rohith8988/Custom_monitor/v2/aluminium_spine/spine_3mm_drawing_1to1_A4.pdf

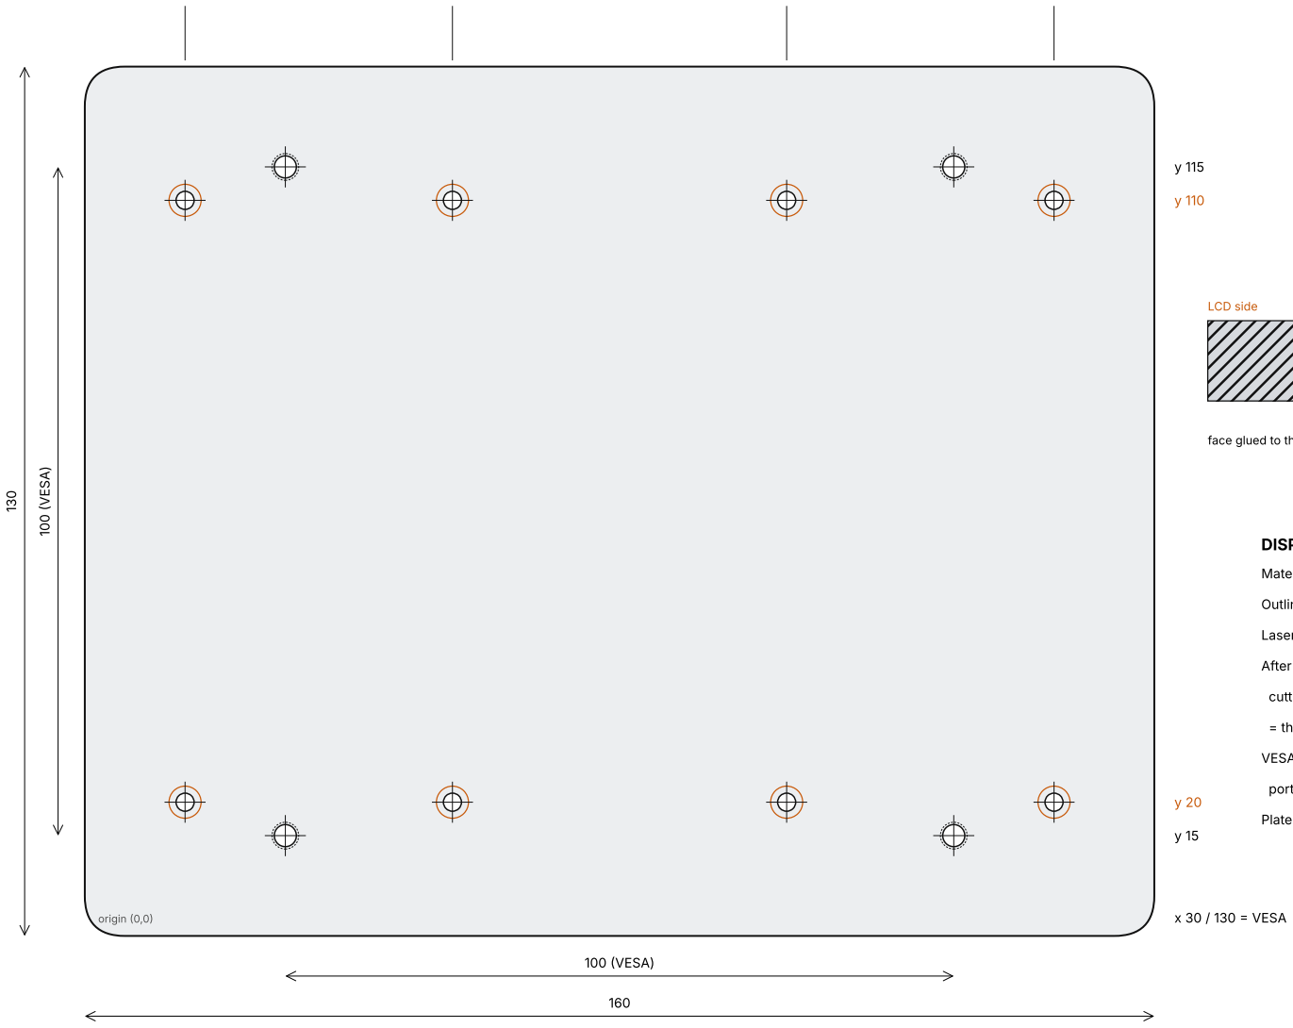
[picture p11: figure]
100 (VESA); origin (0,0); x 30 / 130 = VESA; LCD side

M2.5 holes at x = 15, 55, 105, 145

50 mm: measure this after printing (print at 100 %, no 'fit to page')

M4 x 0.7
tap through
(Ø3.3 cut)

Ø2.7 through,
90° csk Ø4.8
on the LCD side

face glued to the rear panel (z = 0)

## Section detail, 4:1 (not to scale with the plate)

### DISPLAY CASE v2 - ALUMINIUM SPINE (VESA carrier)

Material: aluminium 6061-T6 (5052 OK), 3.0 mm. Qty 1. Deburr all edges.

Outline 160 x 130, R6 corners. Drawing is 1:1 on A4 (also a drilling template).

Laser cut: outline + 4 x Ø3.3 (+ 8 x Ø2.7 if accepted).

After cutting: tap the 4 x Ø3.3 holes M4 x 0.7 THROUGH (plain M4 tap,

cutting fluid). Countersink the 8 x Ø2.7 holes 90° to Ø4.8 on ONE face

= the LCD side. The other face is epoxied to the rear panel.

VESA screw: M4 must stick out <= 5.5 mm past the arm plate (M4 x 8 with the

portable stand's plate gives 4.4). Longer reaches toward the LCD.

Plate is symmetric: any orientation, only the countersink face matters.
