rohith8988/Custom_monitor/images/controller_board.png

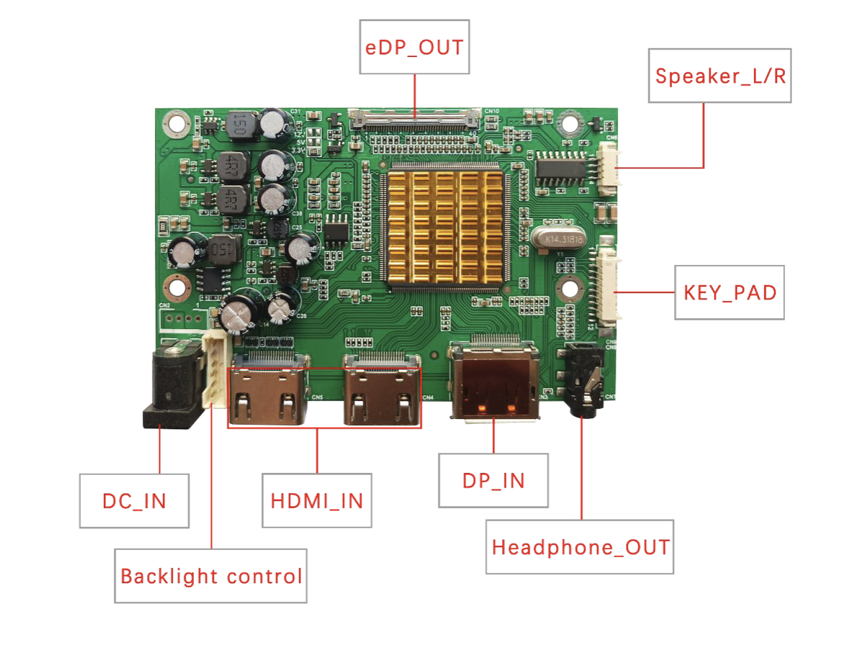
images/controller_board.png
