rohith8988/Custom_monitor/images/controller_board_diagram.png

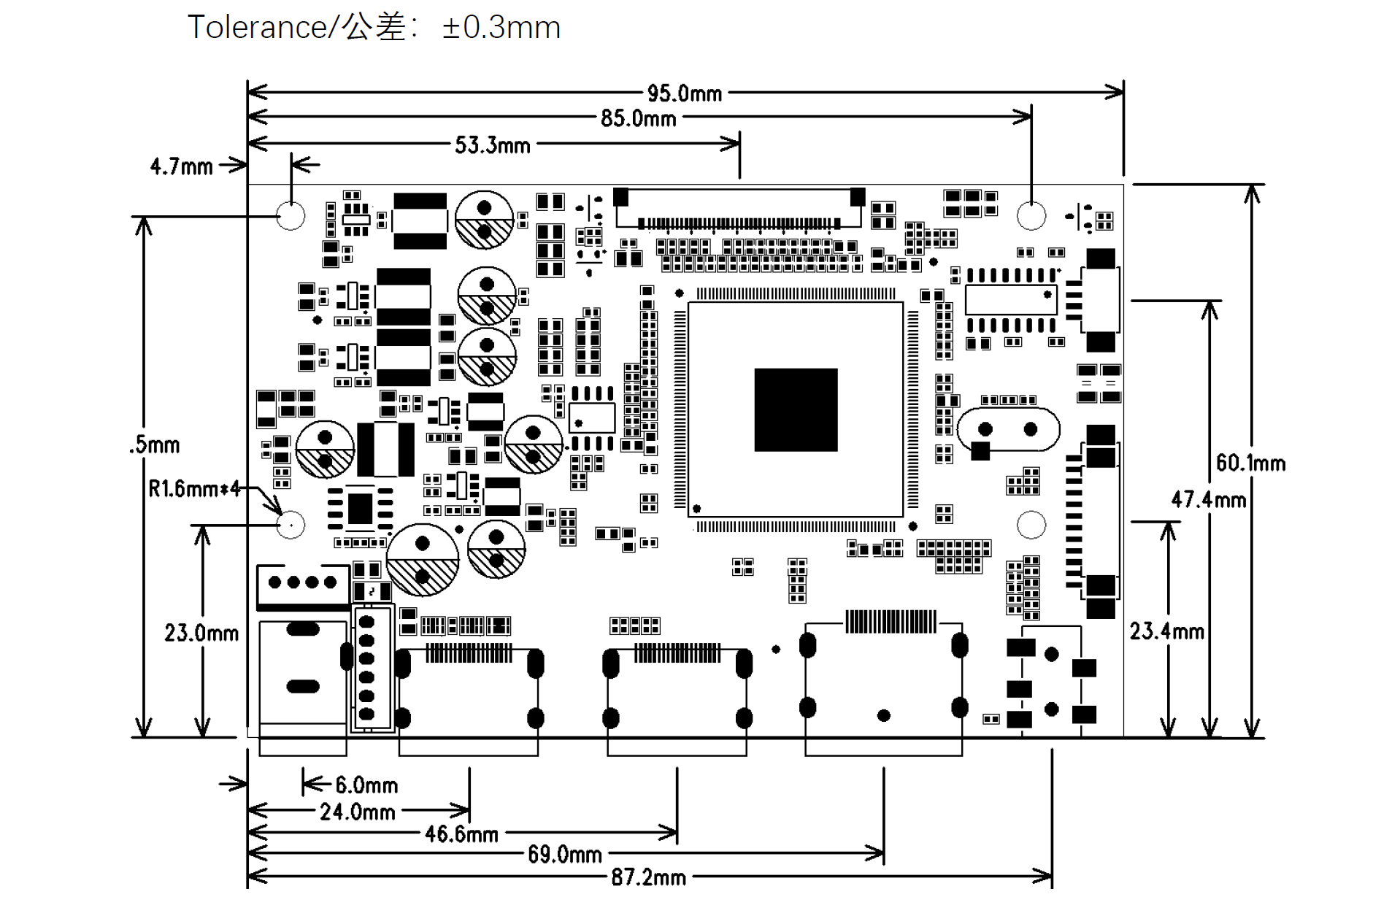
images/controller_board_diagram.png
