rohith8988/Custom_monitor/images/inspiration_pic_1.png

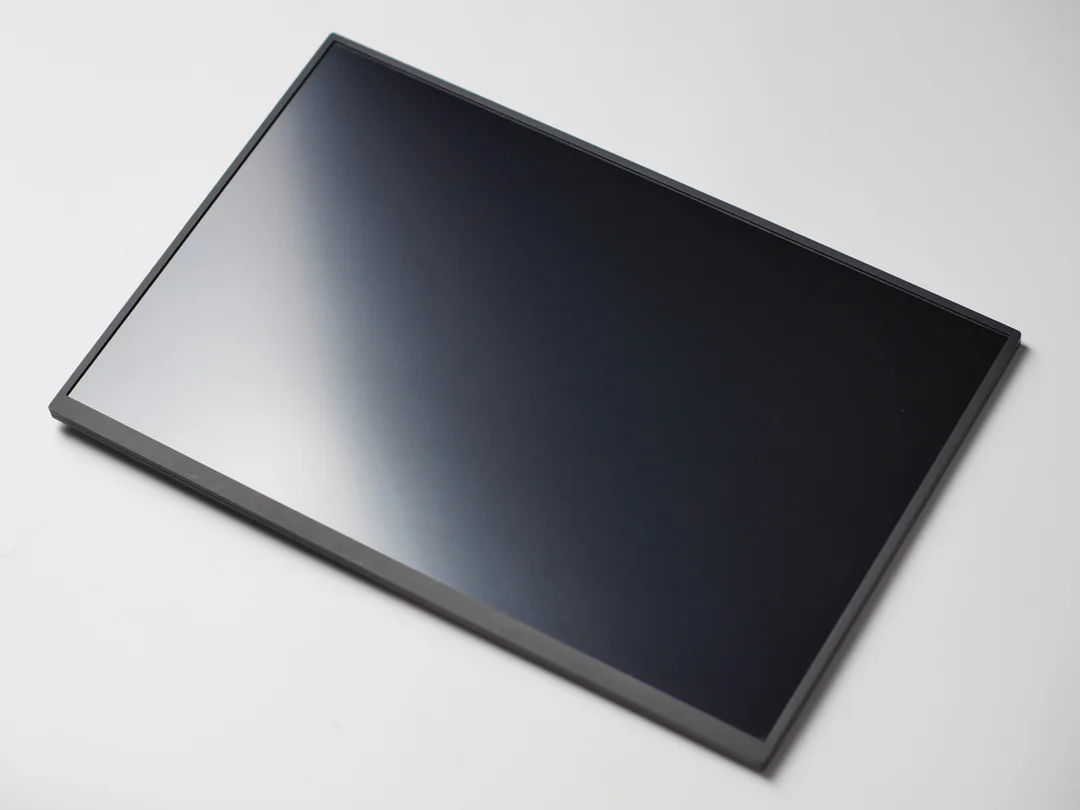
images/inspiration_pic_1.png
