rohith8988/Custom_monitor/images/inspiration_pic_2.png

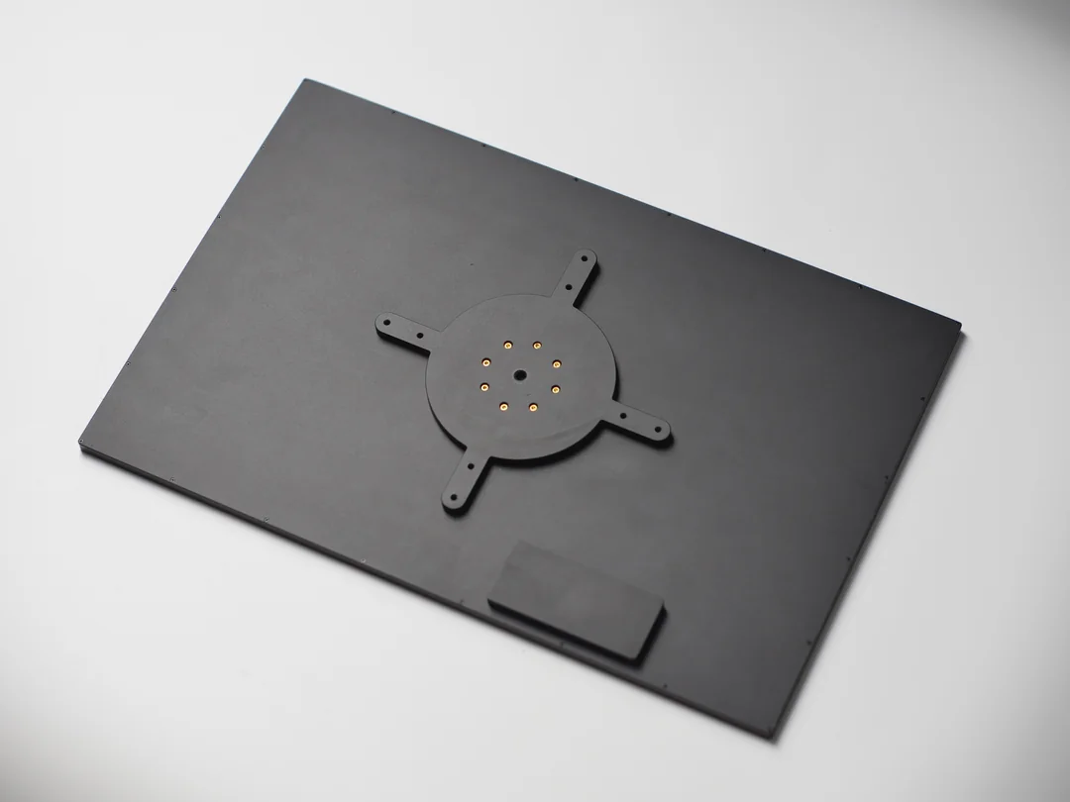
images/inspiration_pic_2.png
