rohith8988/Custom_monitor/images/inspiration_pic_3.png

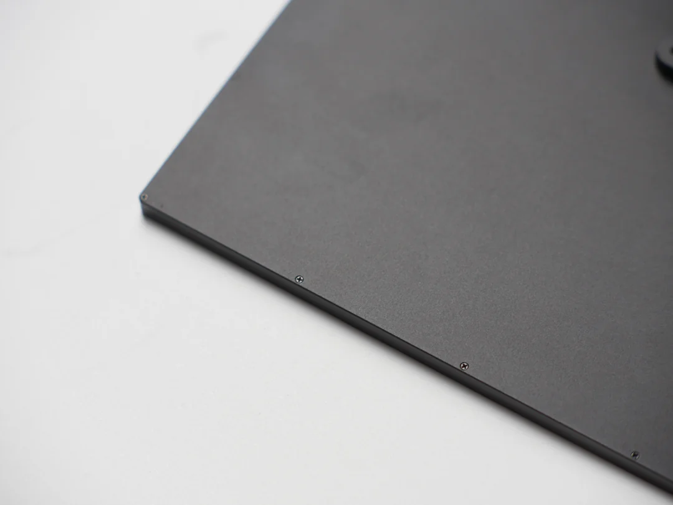
images/inspiration_pic_3.png
