rohith8988/Custom_monitor/images/inspiration_pic_4.png

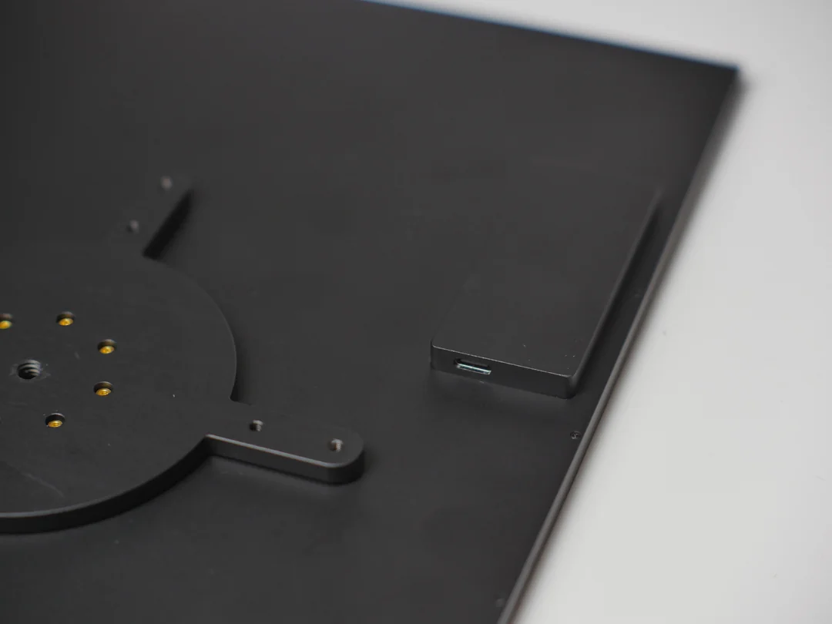
images/inspiration_pic_4.png
