rohith8988/Custom_monitor/stand/renders/front_three_quarter.png

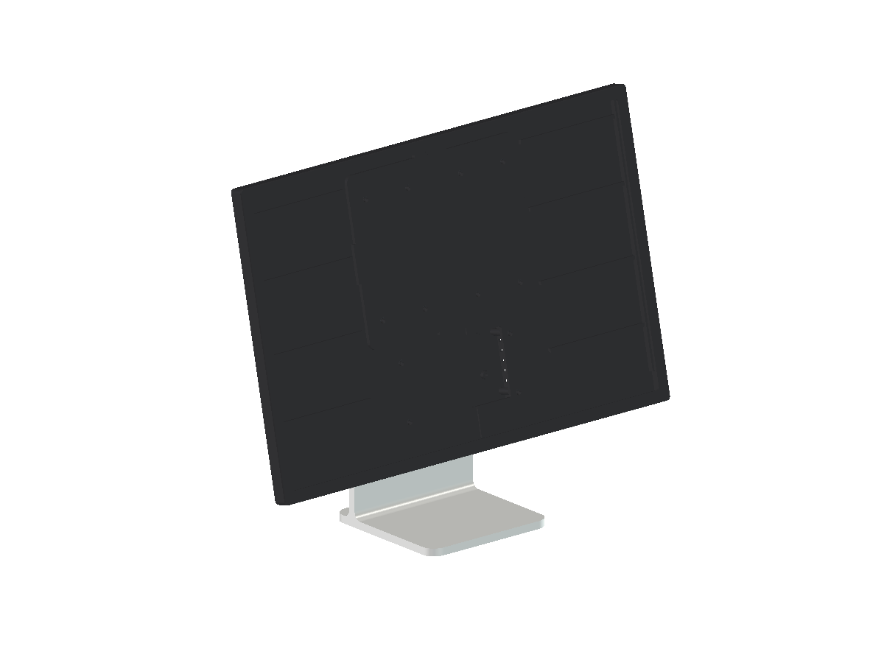
stand/renders/front_three_quarter.png
