rohith8988/Custom_monitor/stand_portable/renders/folded.png

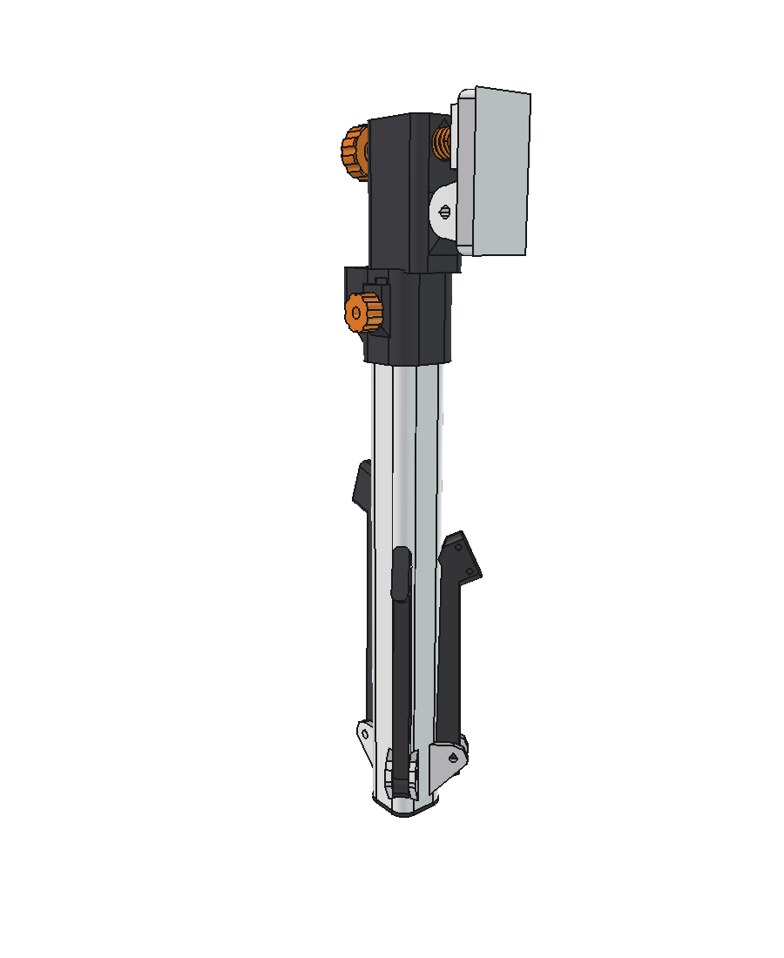
stand_portable/renders/folded.png
