rohith8988/Custom_monitor/stand_portable/renders/stacked_rear_three_quarter.png

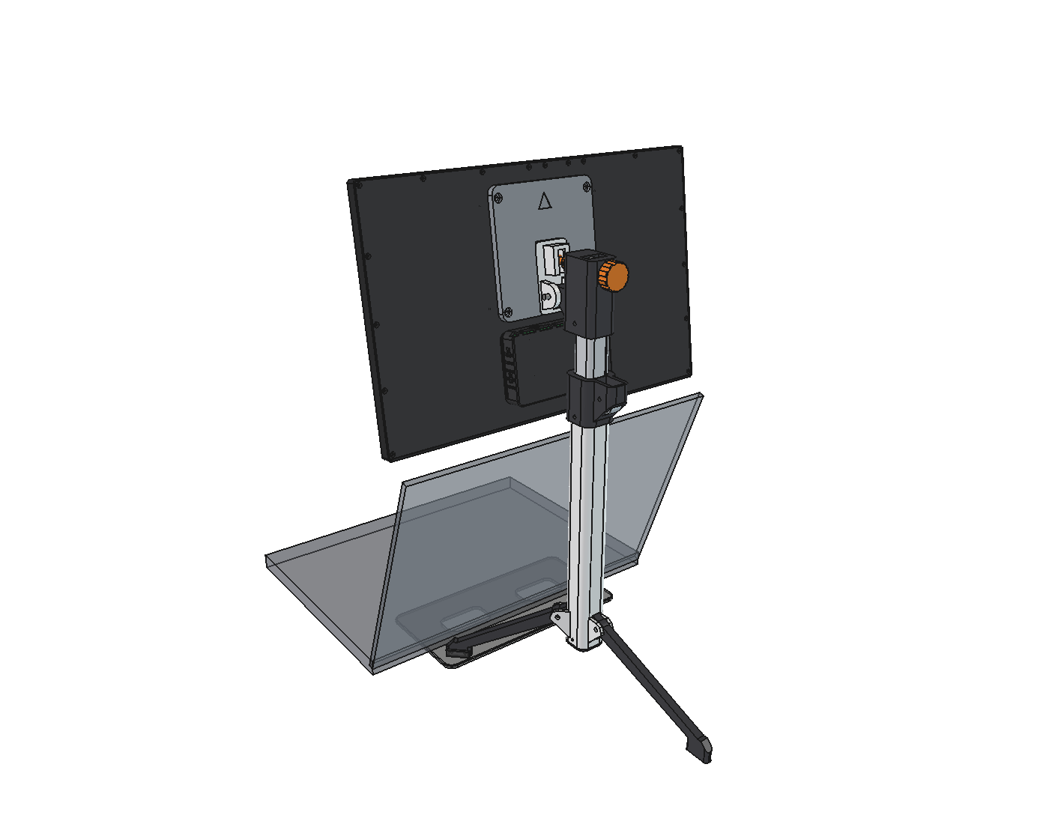
stand_portable/renders/stacked_rear_three_quarter.png
