rohith8988/Custom_monitor/stand_portable/renders/stand_only.png

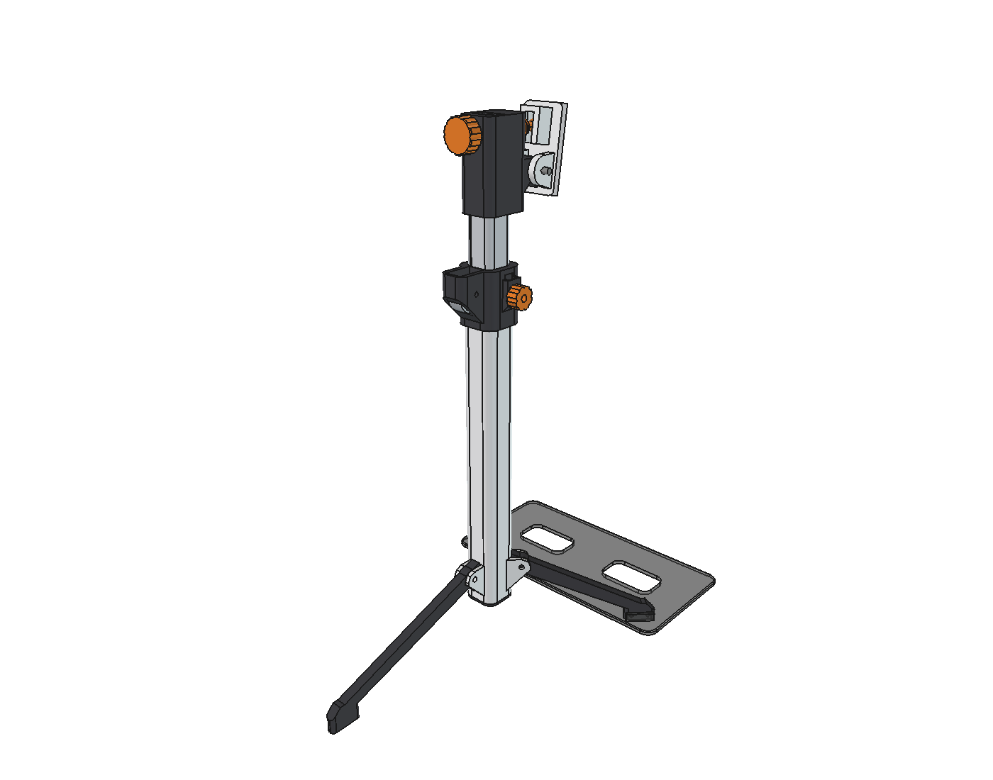
stand_portable/renders/stand_only.png
