rohith8988/Custom_monitor/v3/renders/rear_panel_inside.png

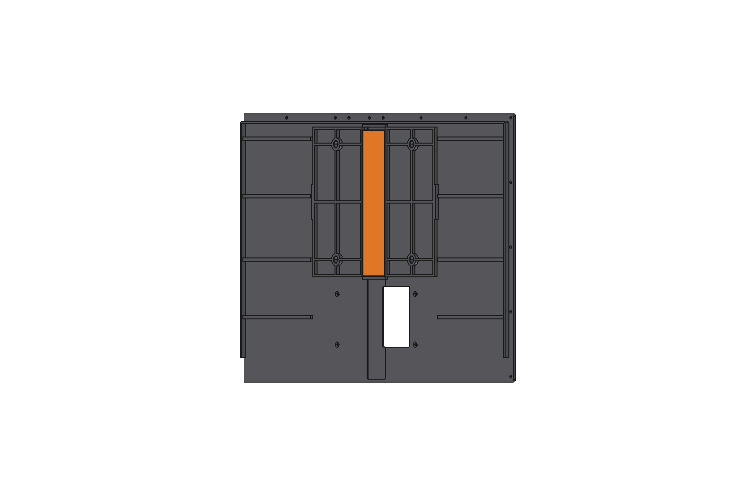
v3/renders/rear_panel_inside.png
