rohith8988/Custom_monitor/stand/source/_case_refs/io_block.stl

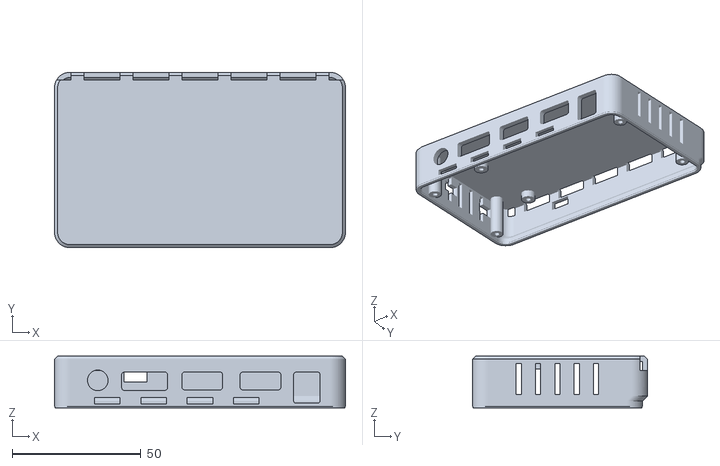
[picture p23: CAD file, 2026-11-06]
stand/source/_case_refs/io_block.stl
113.0 x 68.1 x 20.1
