rohith8988/Custom_monitor/stand_portable/3d_print_files/brake_pad.step

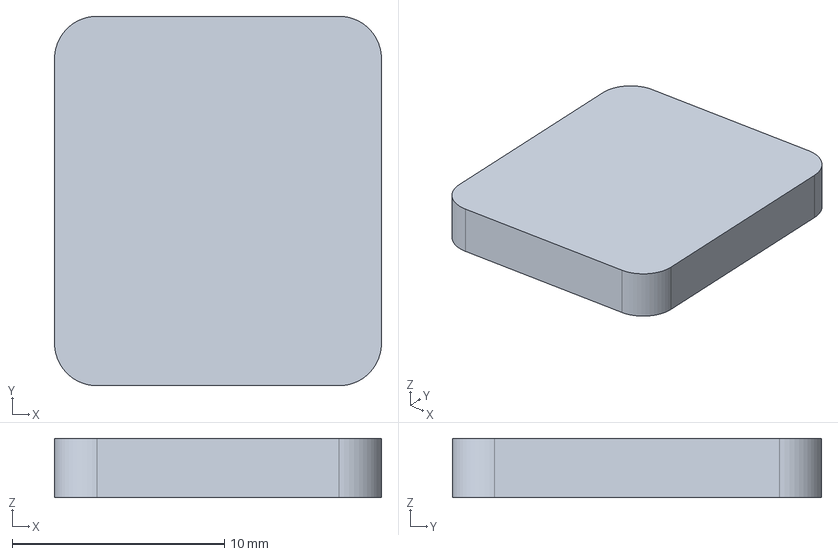
[picture p24: CAD file, 2026-11-06]
stand_portable/3d_print_files/brake_pad.step
15.4 x 17.4 x 2.80 mm
