rohith8988/Custom_monitor/stand_portable/stand_portable_folded.FCStd

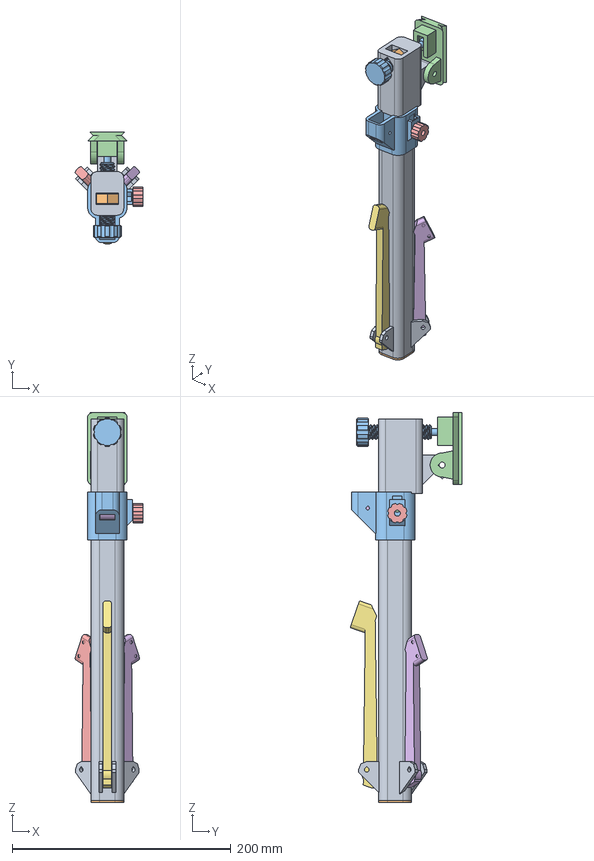
[picture p25: CAD file, 2026-11-06]
stand_portable/stand_portable_folded.FCStd
62.0 x 102.1 x 356.5 mm
outer_tube
bottom_cap
top_collar
brake_pad
brake_knob
spring_drum
inner_tube
inner_foot
head
tilt_nut
tilt_screw
bracket
leg_front_L
leg_front_R
leg_rear
