rohith8988/Custom_monitor/v3/3d_print_files/front_frame_R.step

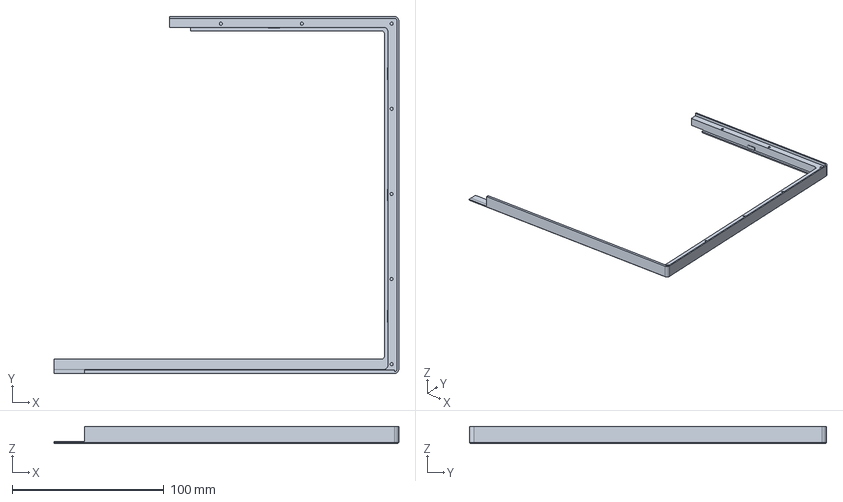
[picture p26: CAD file, 2026-11-06]
v3/3d_print_files/front_frame_R.step
227.4 x 235.5 x 11.3 mm
