rohith8988/Custom_monitor/v3/monitor_case_v3.FCStd

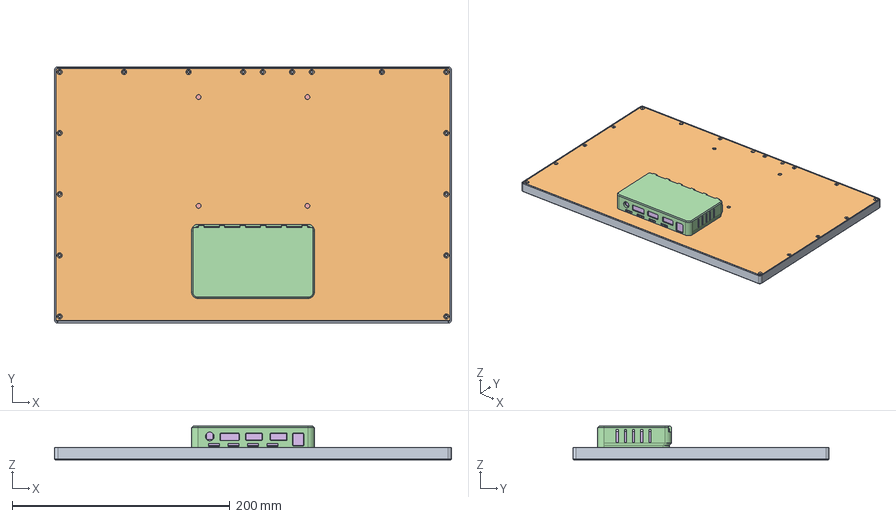
[picture p27: CAD file, 2026-11-06]
v3/monitor_case_v3.FCStd
364.8 x 235.5 x 30.8 mm
front_frame
rear_panel
seam_bridge
io_block
panel_ref
board_ref
