rohith8988/Custom_monitor/v3/print_beds/bed3_rear_panel_L/bed3_rear_panel_L.step

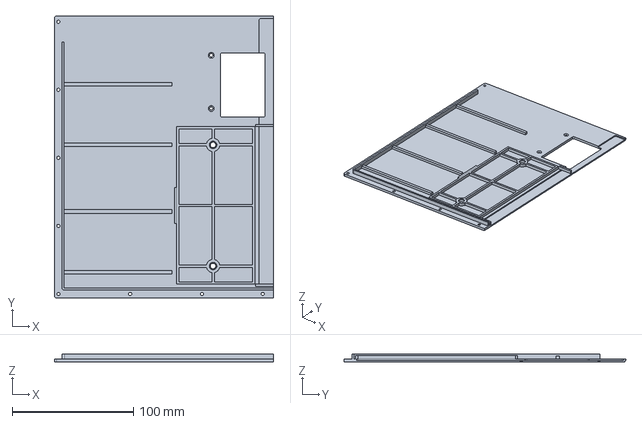
[picture p28: CAD file, 2026-11-06]
v3/print_beds/bed3_rear_panel_L/bed3_rear_panel_L.step
181.0 x 232.7 x 6.70 mm
