rohith8988/Custom_monitor/v3/print_beds/bed4_rear_panel_R/bed4_rear_panel_R.step

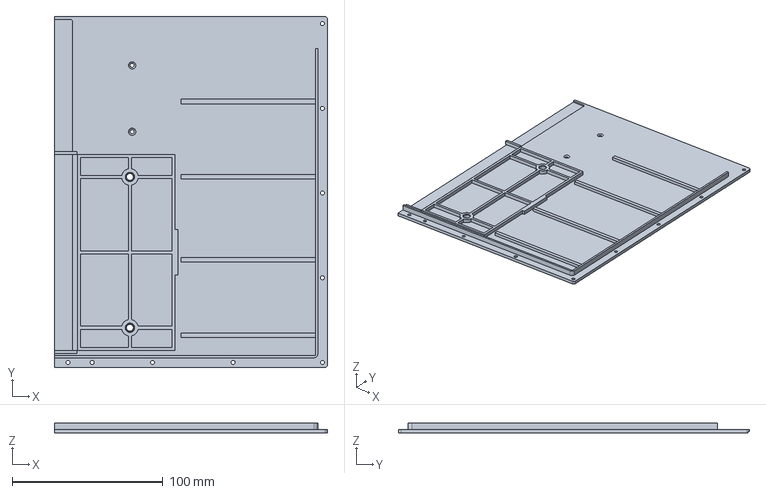
[picture p29: CAD file, 2026-11-06]
v3/print_beds/bed4_rear_panel_R/bed4_rear_panel_R.step
181.0 x 232.7 x 6.70 mm
