rohith8988/Custom_monitor/v3/print_beds/bed5_io_block_splice/bed5_io_block_splice.step

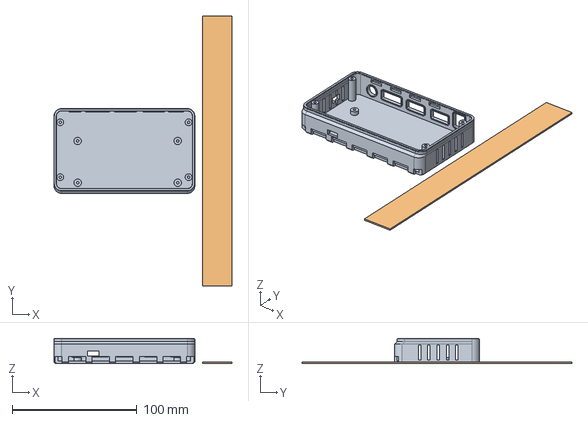
[picture p30: CAD file, 2026-11-06]
v3/print_beds/bed5_io_block_splice/bed5_io_block_splice.step
142.9 x 216.4 x 20.1 mm
