rohith8988/Custom_monitor/v3/print_beds/bed5_io_block_splice/originals/rear_splice.step

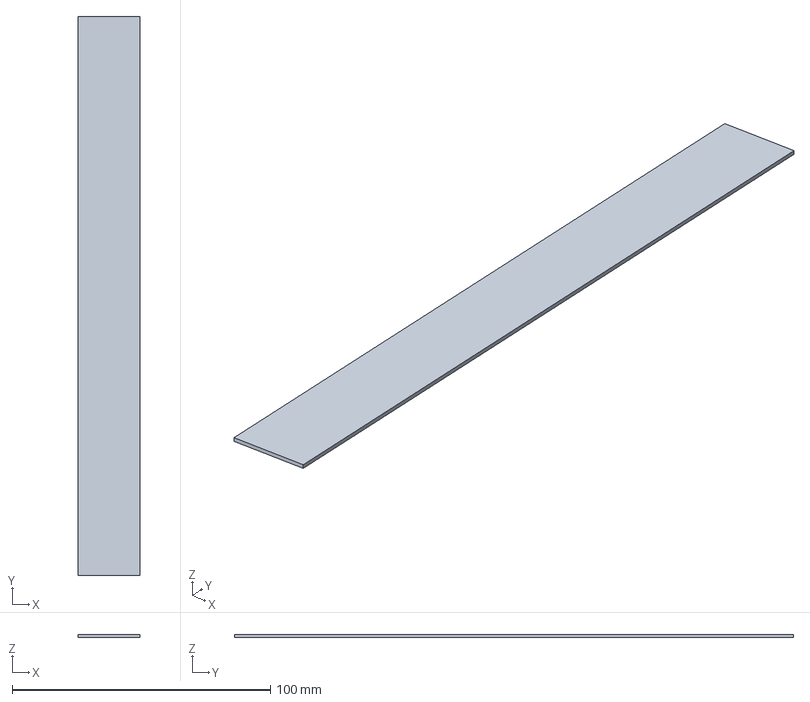
[picture p31: CAD file, 2026-11-06]
v3/print_beds/bed5_io_block_splice/originals/rear_splice.step
23.9 x 216.4 x 1.15 mm
