rohith8988/Custom_monitor/v3/print_beds/bed6_seam_bridge/bed6_seam_bridge.step

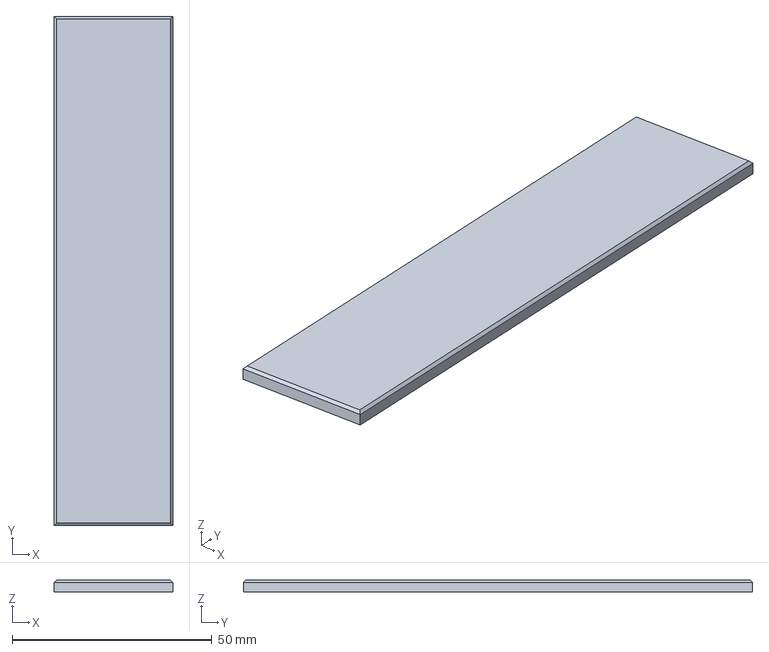
[picture p32: CAD file, 2026-11-06]
v3/print_beds/bed6_seam_bridge/bed6_seam_bridge.step
29.7 x 127.4 x 3.00 mm
