rohith8988/Custom_monitor/stand/source/_case_refs/spine.stl

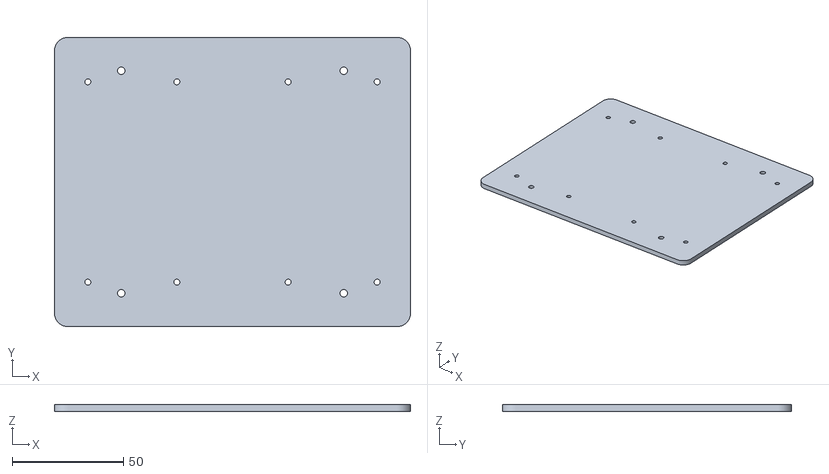
[picture p33: CAD file, 2026-11-06]
stand/source/_case_refs/spine.stl
160.0 x 130.0 x 3.00
