rohith8988/Custom_monitor/stand_portable/3d_print_files/vesa_plate.step

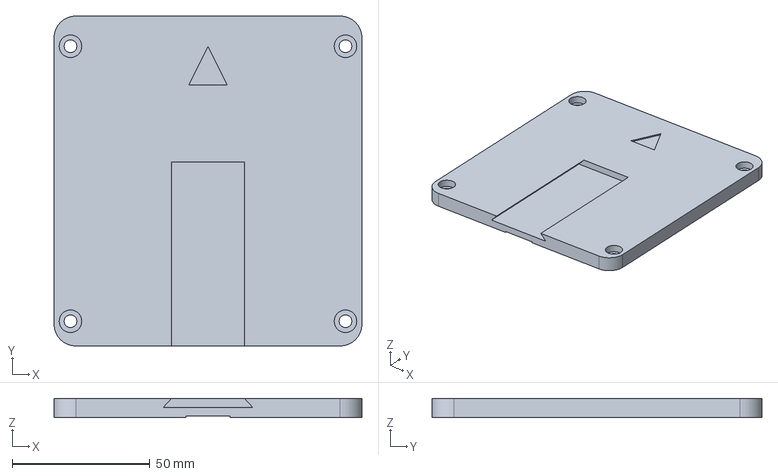
[picture p34: CAD file, 2026-11-06]
stand_portable/3d_print_files/vesa_plate.step
112.0 x 120.0 x 7.00 mm
