rohith8988/Custom_monitor/stand_portable/stand_portable.FCStd

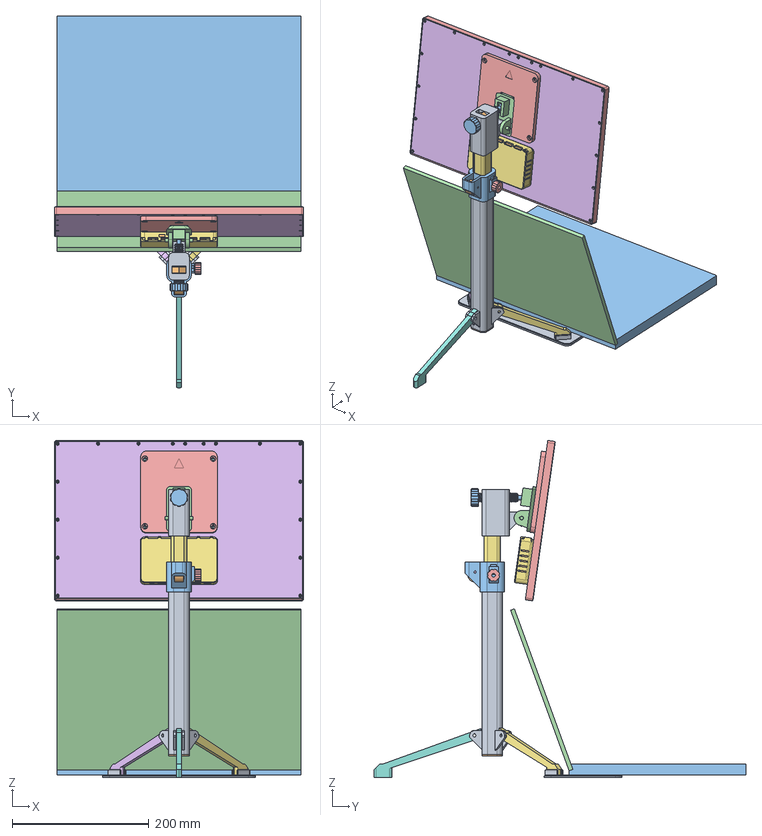
[picture p35: CAD file, 2026-11-06]
stand_portable/stand_portable.FCStd
364.8 x 544.3 x 493.2 mm
outer_tube
bottom_cap
top_collar
brake_pad
brake_knob
spring_drum
inner_tube
inner_foot
head
tilt_nut
tilt_screw
bracket
vesa_plate
leg_front_L
leg_front_R
leg_rear
laptop_plate
cf_spring_coil
cf_spring_strip
m5_pivot
front_frame
rear_panel
io_block
spine
panel_ref
board_ref
laptop_deck
laptop_lid
