rohith8988/Custom_monitor/stand/source/_case_refs/rear_panel.stl

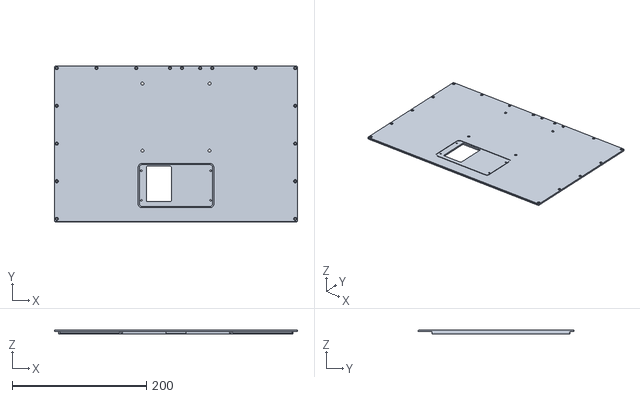
[picture p36: CAD file, 2026-11-06]
stand/source/_case_refs/rear_panel.stl
362.0 x 232.7 x 6.70
