rohith8988/Custom_monitor/stand_portable/3d_print_files/spring_drum.step

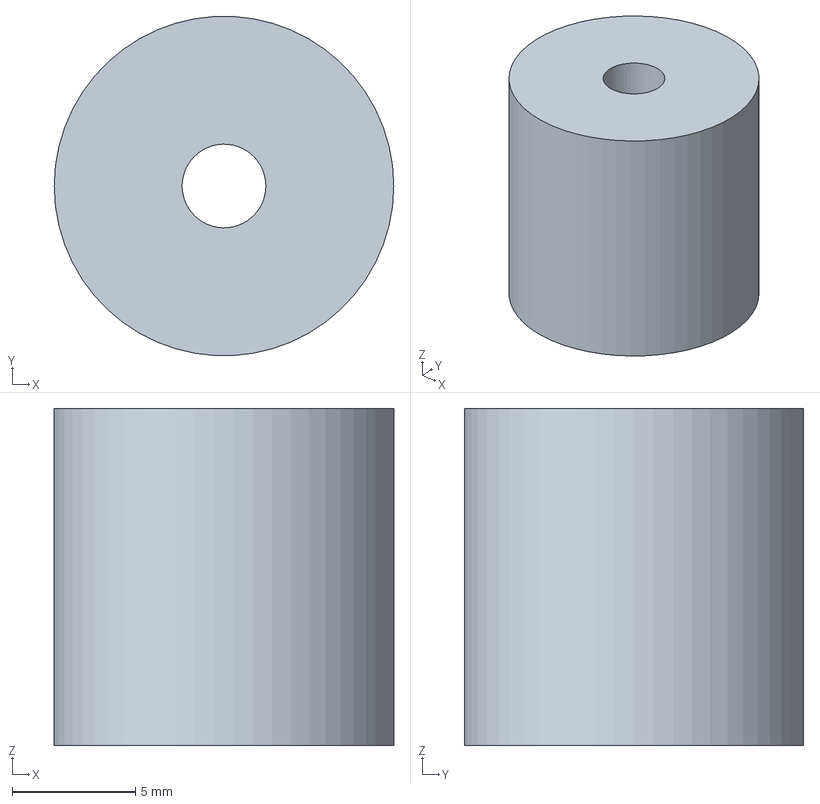
[picture p37: CAD file, 2026-11-06]
stand_portable/3d_print_files/spring_drum.step
13.8 x 13.8 x 13.7 mm
