rohith8988/Custom_monitor/stand/source/_case_refs/front_frame.stl

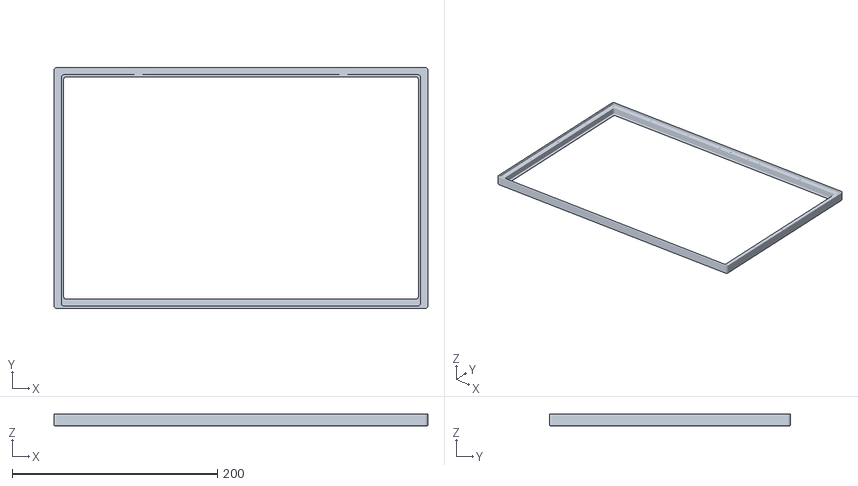
[picture p38: CAD file, 2026-11-06]
stand/source/_case_refs/front_frame.stl
364.8 x 235.5 x 11.3
