rohith8988/Custom_monitor/stand_portable/3d_print_files/inner_foot.step

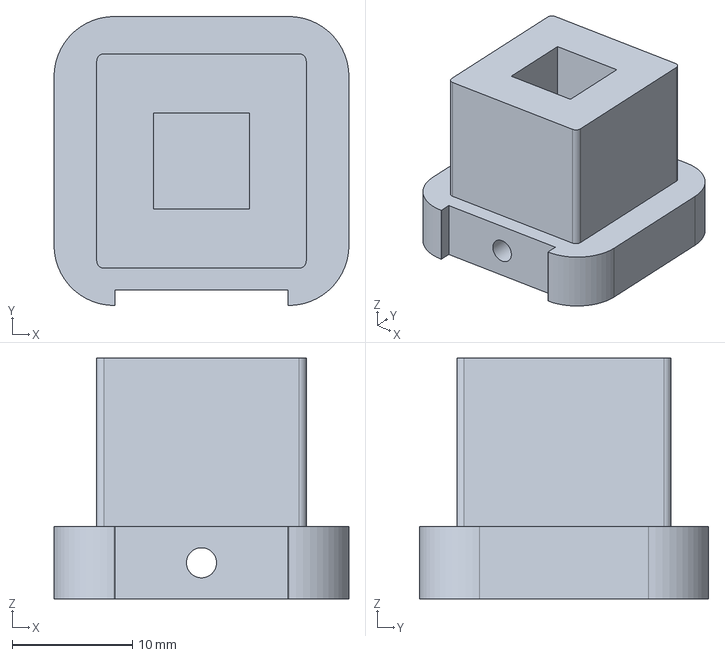
[picture p39: CAD file, 2026-11-06]
stand_portable/3d_print_files/inner_foot.step
24.5 x 24.0 x 20.0 mm
