rohith8988/Custom_monitor/stand_portable/3d_print_files/laptop_plate.step

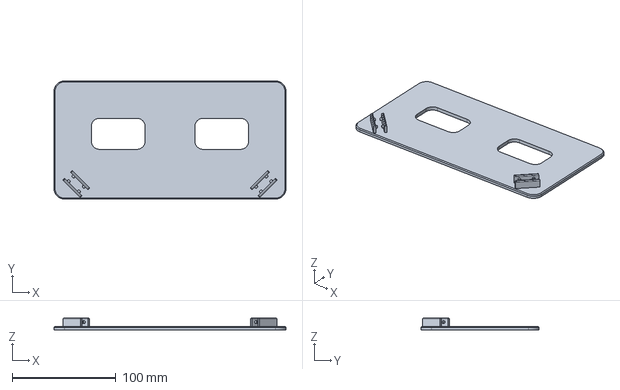
[picture p40: CAD file, 2026-11-06]
stand_portable/3d_print_files/laptop_plate.step
224.0 x 114.0 x 11.5 mm
