rohith8988/Custom_monitor/stand_portable/3d_print_files/bottom_cap.step

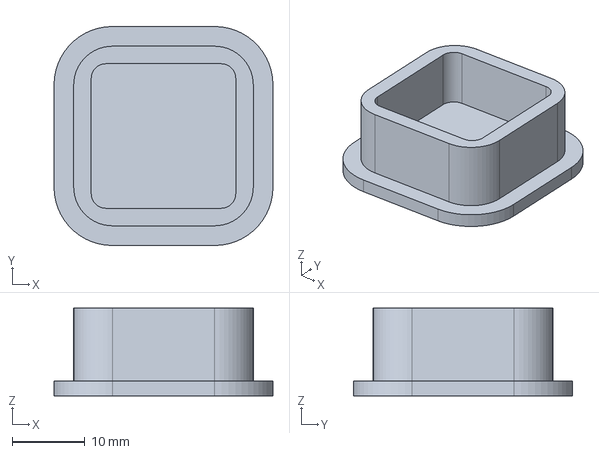
[picture p41: CAD file, 2026-11-06]
stand_portable/3d_print_files/bottom_cap.step
30.0 x 30.0 x 12.0 mm
