rohith8988/Custom_monitor/stand_portable/3d_print_files/brake_knob.step

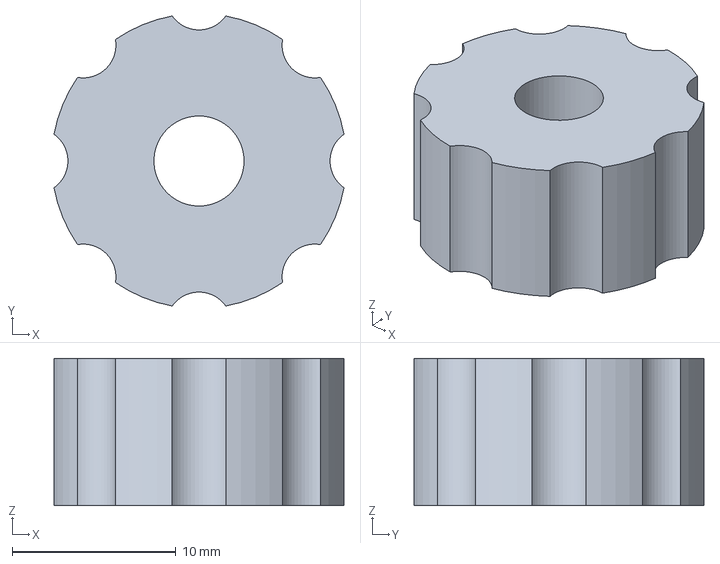
[picture p42: CAD file, 2026-11-06]
stand_portable/3d_print_files/brake_knob.step
17.7 x 17.7 x 9.00 mm
