rohith8988/Custom_monitor/v3/3d_print_files/rear_panel_L_selfsupport.step

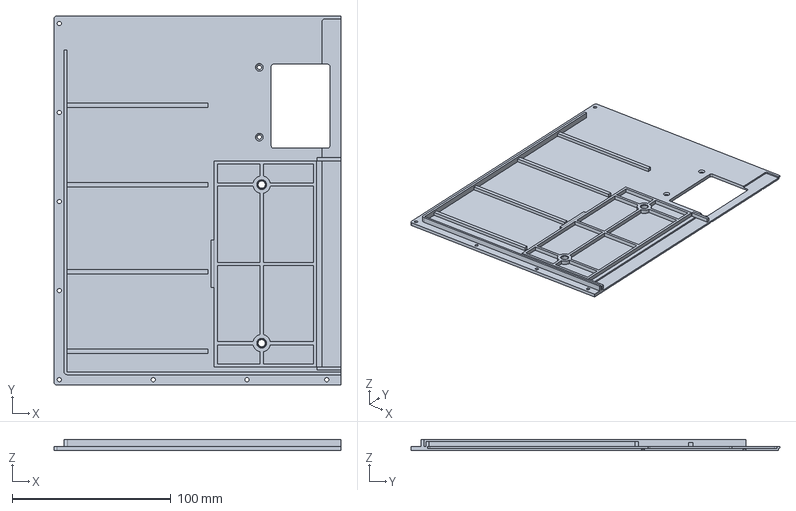
[picture p43: CAD file, 2026-11-06]
v3/3d_print_files/rear_panel_L_selfsupport.step
181.0 x 232.7 x 6.70 mm
