rohith8988/Custom_monitor/stand_portable/3d_print_files/top_collar.step

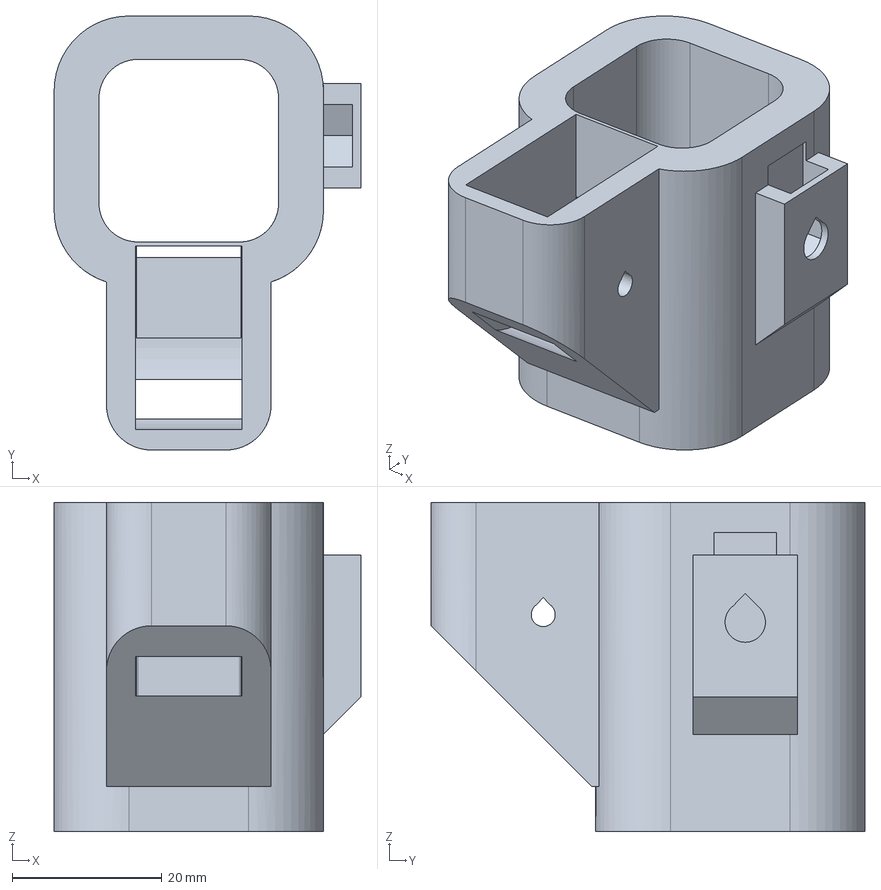
[picture p44: CAD file, 2026-11-06]
stand_portable/3d_print_files/top_collar.step
41.0 x 58.0 x 44.0 mm
