rohith8988/Custom_monitor/stand_portable/3d_print_files/inner_tube.step

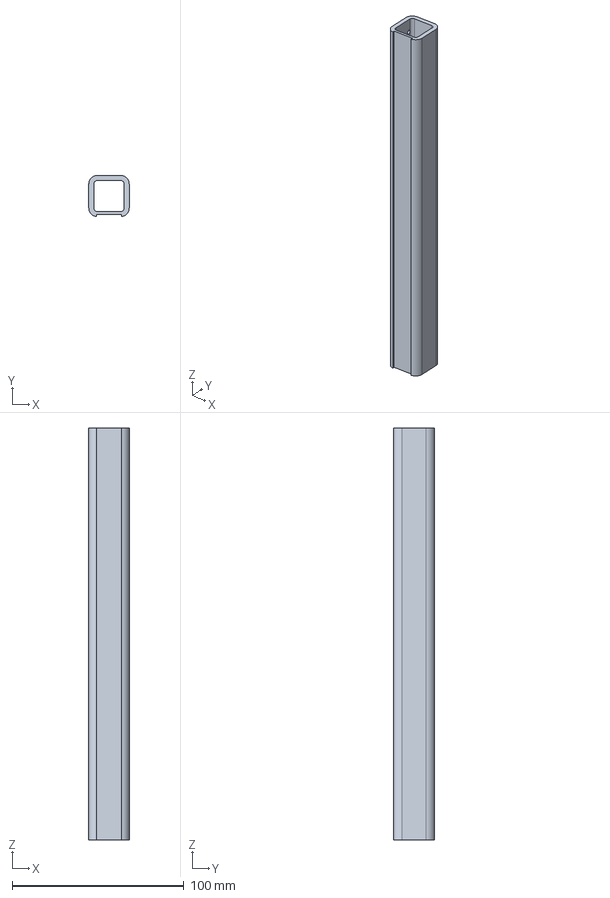
[picture p45: CAD file, 2026-11-06]
stand_portable/3d_print_files/inner_tube.step
23.6 x 24.0 x 240.0 mm
