rohith8988/Custom_monitor/stand_portable/3d_print_files/leg_front_R.step

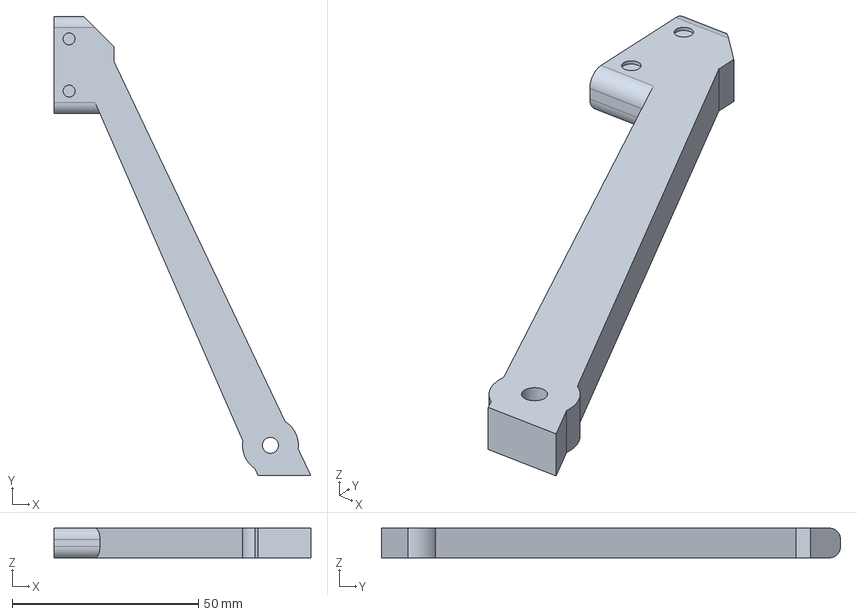
[picture p46: CAD file, 2026-11-06]
stand_portable/3d_print_files/leg_front_R.step
68.8 x 123.1 x 8.00 mm
