rohith8988/Custom_monitor/stand_portable/3d_print_files/leg_rear.step

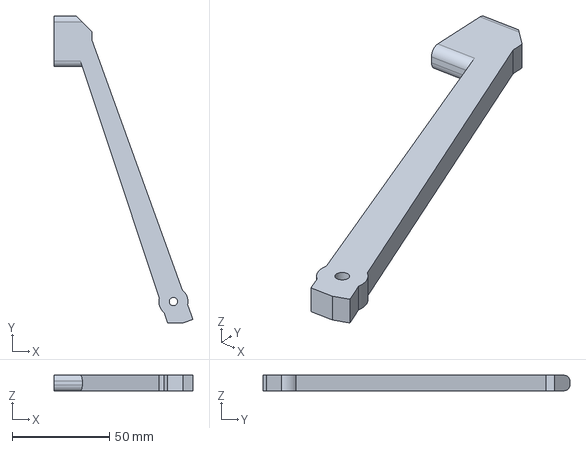
[picture p47: CAD file, 2026-11-06]
stand_portable/3d_print_files/leg_rear.step
71.6 x 158.0 x 8.00 mm
