rohith8988/Custom_monitor/stand_portable/3d_print_files/head.step

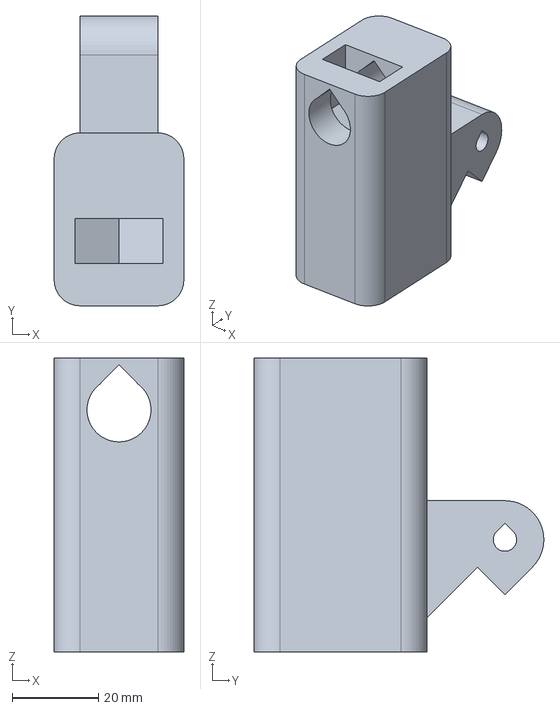
[picture p48: CAD file, 2026-11-06]
stand_portable/3d_print_files/head.step
30.0 x 67.0 x 68.0 mm
