rohith8988/Custom_monitor/stand_portable/3d_print_files/outer_tube.step

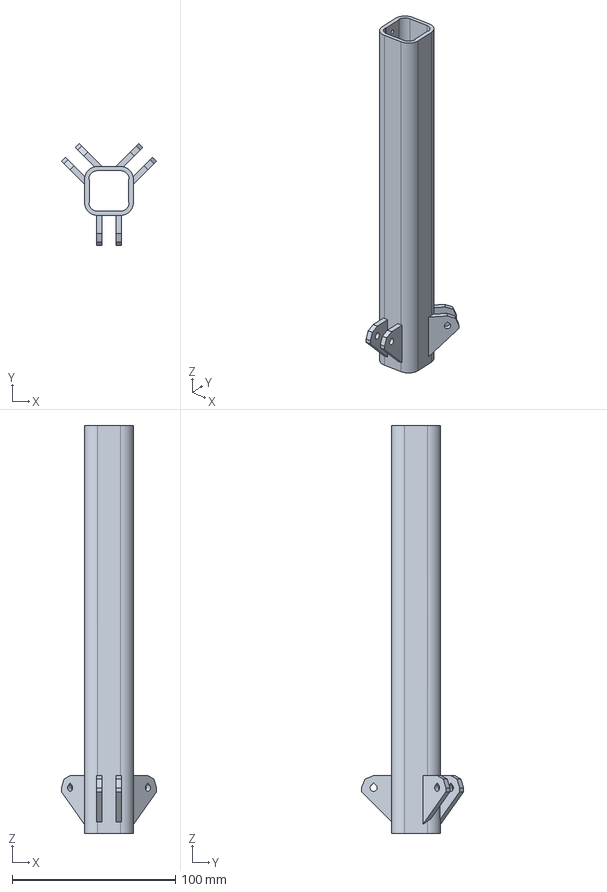
[picture p49: CAD file, 2026-11-06]
stand_portable/3d_print_files/outer_tube.step
58.3 x 62.6 x 250.0 mm
