rohith8988/Custom_monitor/stand_portable/3d_print_files/bracket.step

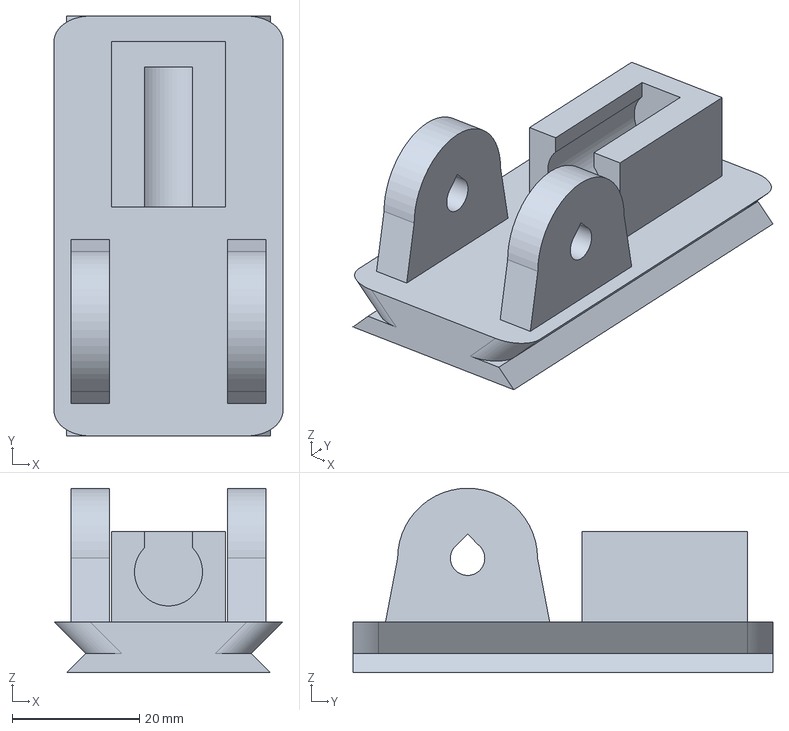
[picture p50: CAD file, 2026-11-06]
stand_portable/3d_print_files/bracket.step
36.0 x 66.0 x 29.0 mm
