rohith8988/Custom_monitor/(list of files, cad)

Other CAD files:
v3/print_beds/bed1_front_frame_L/bed1_front_frame_L.step
v3/print_beds/bed1_front_frame_L/originals/front_frame_L.step
v3/print_beds/bed2_front_frame_R/bed2_front_frame_R.step
v3/print_beds/bed2_front_frame_R/originals/front_frame_R.step
v3/print_beds/bed3_rear_panel_L/originals/rear_panel_L.step
v3/print_beds/bed4_rear_panel_R/originals/rear_panel_R.step
v3/3d_print_files/front_frame_R_selfsupport.step
v3/print_beds/bed5_io_block_splice/originals/io_block.step
v3/3d_print_files/front_frame_L.step
v3/3d_print_files/rear_panel_R_selfsupport.step
v3/3d_print_files/front_frame_L_selfsupport.step
v3/3d_print_files/rear_panel_R.step
v3/3d_print_files/rear_splice.step
v3/3d_print_files/seam_bridge.step
v3/3d_print_files/io_block.step
v3/3d_print_files/rear_panel_L.step
stand_portable/3d_print_files/leg_front_L.step
stand_portable/3d_print_files/bottom_cap.stl
stand_portable/3d_print_files/bracket.stl
stand_portable/3d_print_files/brake_knob.stl
stand_portable/3d_print_files/brake_pad.stl
stand_portable/3d_print_files/head.stl
stand_portable/3d_print_files/inner_foot.stl
stand_portable/3d_print_files/inner_tube.stl
stand_portable/3d_print_files/laptop_plate.stl
stand_portable/3d_print_files/leg_front_L.stl
stand_portable/3d_print_files/leg_front_R.stl
stand_portable/3d_print_files/leg_rear.stl
stand_portable/3d_print_files/outer_tube.stl
stand_portable/3d_print_files/spring_drum.stl
stand_portable/3d_print_files/tilt_nut.step
stand_portable/3d_print_files/tilt_nut.stl
stand_portable/3d_print_files/tilt_screw.step
stand_portable/3d_print_files/tilt_screw.stl
stand_portable/3d_print_files/top_collar.stl
stand_portable/3d_print_files/vesa_plate.stl
v1/3d_print_files/frame_key.step
v1/3d_print_files/frame_key.stl
v1/3d_print_files/front_frame_L.step
v1/3d_print_files/front_frame_L.stl
v1/3d_print_files/front_frame_R.step
v1/3d_print_files/front_frame_R.stl
v1/3d_print_files/io_block.step
v1/3d_print_files/io_block.stl
v1/3d_print_files/rear_panel_L.step
v1/3d_print_files/rear_panel_L.stl
v1/3d_print_files/rear_panel_R.step
v1/3d_print_files/rear_panel_R.stl
v1/3d_print_files/rear_splice.step
v1/3d_print_files/rear_splice.stl
v1/DisplayCase_VESA.FCStd
v1/print_beds/bed1_front_frame_L/bed1_front_frame_L.step
v1/print_beds/bed1_front_frame_L/bed1_front_frame_L.stl
v1/print_beds/bed1_front_frame_L/originals/front_frame_L.step
v1/print_beds/bed1_front_frame_L/originals/front_frame_L.stl
v1/print_beds/bed2_front_frame_R/bed2_front_frame_R.step
v1/print_beds/bed2_front_frame_R/bed2_front_frame_R.stl
v1/print_beds/bed2_front_frame_R/originals/front_frame_R.step
v1/print_beds/bed2_front_frame_R/originals/front_frame_R.stl
v1/print_beds/bed3_rear_panel_L_vesa/bed3_rear_panel_L_vesa_plus_splice.step
v1/print_beds/bed3_rear_panel_L_vesa/bed3_rear_panel_L_vesa_plus_splice.stl
v1/print_beds/bed3_rear_panel_L_vesa/originals/rear_panel_L_vesa.step
v1/print_beds/bed3_rear_panel_L_vesa/originals/rear_panel_L_vesa.stl
v1/print_beds/bed3_rear_panel_L_vesa/originals/rear_splice.step
v1/print_beds/bed3_rear_panel_L_vesa/originals/rear_splice.stl
v1/print_beds/bed4_rear_panel_R_vesa/bed4_rear_panel_R_vesa_plus_ioblock_key.step
v1/print_beds/bed4_rear_panel_R_vesa/bed4_rear_panel_R_vesa_plus_ioblock_key.stl
v1/print_beds/bed4_rear_panel_R_vesa/originals/frame_key.step
v1/print_beds/bed4_rear_panel_R_vesa/originals/frame_key.stl
v1/print_beds/bed4_rear_panel_R_vesa/originals/io_block.step
v1/print_beds/bed4_rear_panel_R_vesa/originals/io_block.stl
v1/print_beds/bed4_rear_panel_R_vesa/originals/rear_panel_R_vesa.step
v1/print_beds/bed4_rear_panel_R_vesa/originals/rear_panel_R_vesa.stl
v1/v1.2/3d_print files/frame_key.step
v1/v1.2/3d_print files/frame_key.stl
v1/v1.2/3d_print files/front_frame_L.step
v1/v1.2/3d_print files/front_frame_L.stl
v1/v1.2/3d_print files/front_frame_R.step
v1/v1.2/3d_print files/front_frame_R.stl
v1/v1.2/3d_print files/io_block.step
v1/v1.2/3d_print files/io_block.stl
v1/v1.2/3d_print files/rear_panel_L.step
v1/v1.2/3d_print files/rear_panel_L.stl
v1/v1.2/3d_print files/rear_panel_R.step
v1/v1.2/3d_print files/rear_panel_R.stl
v1/v1.2/3d_print files/rear_splice.step
v1/v1.2/3d_print files/rear_splice.stl
v1/v1.2/3d_print files/stand/stand_bracket.step
v1/v1.2/3d_print files/stand/stand_bracket.stl
v1/v1.2/3d_print files/stand/stand_leg.step
v1/v1.2/3d_print files/stand/stand_leg.stl
v1/v1.2/3d_print files/vesa/rear_panel_L.step
v1/v1.2/3d_print files/vesa/rear_panel_L.stl
v1/v1.2/3d_print files/vesa/rear_panel_R.step
v1/v1.2/3d_print files/vesa/rear_panel_R.stl
v1/v1.2/build/v2-stand_assembly.step
v1/v1.2/build/v2-vesa_assembly.step
v1/v1.2/build/v2_assembly.step
v2/3d_print_files/front_frame_L.step
v2/3d_print_files/front_frame_L.stl
v2/3d_print_files/front_frame_L_selfsupport.step
v2/3d_print_files/front_frame_L_selfsupport.stl
v2/3d_print_files/front_frame_R.stl
v2/3d_print_files/front_frame_R_selfsupport.step
v2/3d_print_files/front_frame_R_selfsupport.stl
v2/3d_print_files/io_block.step
v2/3d_print_files/io_block.stl
v2/3d_print_files/rear_panel_L.step
v2/3d_print_files/rear_panel_L.stl
v2/3d_print_files/rear_panel_L_selfsupport.step
v2/3d_print_files/rear_panel_L_selfsupport.stl
v2/3d_print_files/rear_panel_R.step
v2/3d_print_files/rear_panel_R.stl
v2/3d_print_files/rear_panel_R_selfsupport.step
v2/3d_print_files/rear_panel_R_selfsupport.stl
v2/3d_print_files/rear_splice.step
v2/3d_print_files/rear_splice.stl
v2/aluminium_spine/spine_3mm_6061.FCStd
v2/aluminium_spine/spine_3mm_6061_plain_holes.step
v2/aluminium_spine/spine_3mm_6061_threaded.step
v2/aluminium_spine/spine_3mm_laser_cut.dxf
v2/aluminium_spine/spine_3mm_laser_cut_no_M2.5_holes.dxf
v2/backup_20261005_before_standoff_fix/3d_models__monitor_case_v2.FCStd
v2/backup_20261005_before_standoff_fix/3d_print_files__io_block.step
v2/backup_20261005_before_standoff_fix/3d_print_files__io_block.stl
v2/backup_20261005_before_standoff_fix/monitor_case_v2.FCStd
v2/backup_20261005_before_standoff_fix/print_beds__bed5_io_block_splice__bed5_io_block_splice.step
v2/backup_20261005_before_standoff_fix/print_beds__bed5_io_block_splice__bed5_io_block_splice.stl
v2/backup_20261005_before_standoff_fix/print_beds__bed5_io_block_splice__originals__io_block.step
v2/backup_20261005_before_standoff_fix/print_beds__bed5_io_block_splice__originals__io_block.stl
v2/monitor_case_v2.FCStd
v2/print_beds/bed1_front_frame_L/bed1_front_frame_L.step
v2/print_beds/bed1_front_frame_L/bed1_front_frame_L.stl
v2/print_beds/bed1_front_frame_L/originals/front_frame_L.step
v2/print_beds/bed1_front_frame_L/originals/front_frame_L.stl
v2/print_beds/bed2_front_frame_R/bed2_front_frame_R.step
v2/print_beds/bed2_front_frame_R/bed2_front_frame_R.stl
v2/print_beds/bed2_front_frame_R/originals/front_frame_R.step
v2/print_beds/bed2_front_frame_R/originals/front_frame_R.stl
v2/print_beds/bed3_rear_panel_L/bed3_rear_panel_L.step
v2/print_beds/bed3_rear_panel_L/bed3_rear_panel_L.stl
v2/print_beds/bed3_rear_panel_L/originals/rear_panel_L.step
v2/print_beds/bed3_rear_panel_L/originals/rear_panel_L.stl
v2/print_beds/bed4_rear_panel_R/bed4_rear_panel_R.step
v2/print_beds/bed4_rear_panel_R/bed4_rear_panel_R.stl
v2/print_beds/bed4_rear_panel_R/originals/rear_panel_R.step
v2/print_beds/bed4_rear_panel_R/originals/rear_panel_R.stl
v2/print_beds/bed5_io_block_splice/bed5_io_block_splice.stl
v2/print_beds/bed5_io_block_splice/originals/io_block.step
v2/print_beds/bed5_io_block_splice/originals/io_block.stl
v2/print_beds/bed5_io_block_splice/originals/rear_splice.stl
v3/3d_print_files/front_frame_L.stl
v3/3d_print_files/front_frame_L_selfsupport.stl
v3/3d_print_files/front_frame_R.stl
v3/3d_print_files/front_frame_R_selfsupport.stl
v3/3d_print_files/io_block.stl
v3/3d_print_files/rear_panel_L.stl
v3/3d_print_files/rear_panel_L_selfsupport.stl
v3/3d_print_files/rear_panel_R.stl
v3/3d_print_files/rear_panel_R_selfsupport.stl
v3/3d_print_files/rear_splice.stl
v3/3d_print_files/seam_bridge.stl
v3/print_beds/bed1_front_frame_L/bed1_front_frame_L.stl
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
