rohith8988/Custom_monitor/v3/3d_print_files/lip_fix_section.png

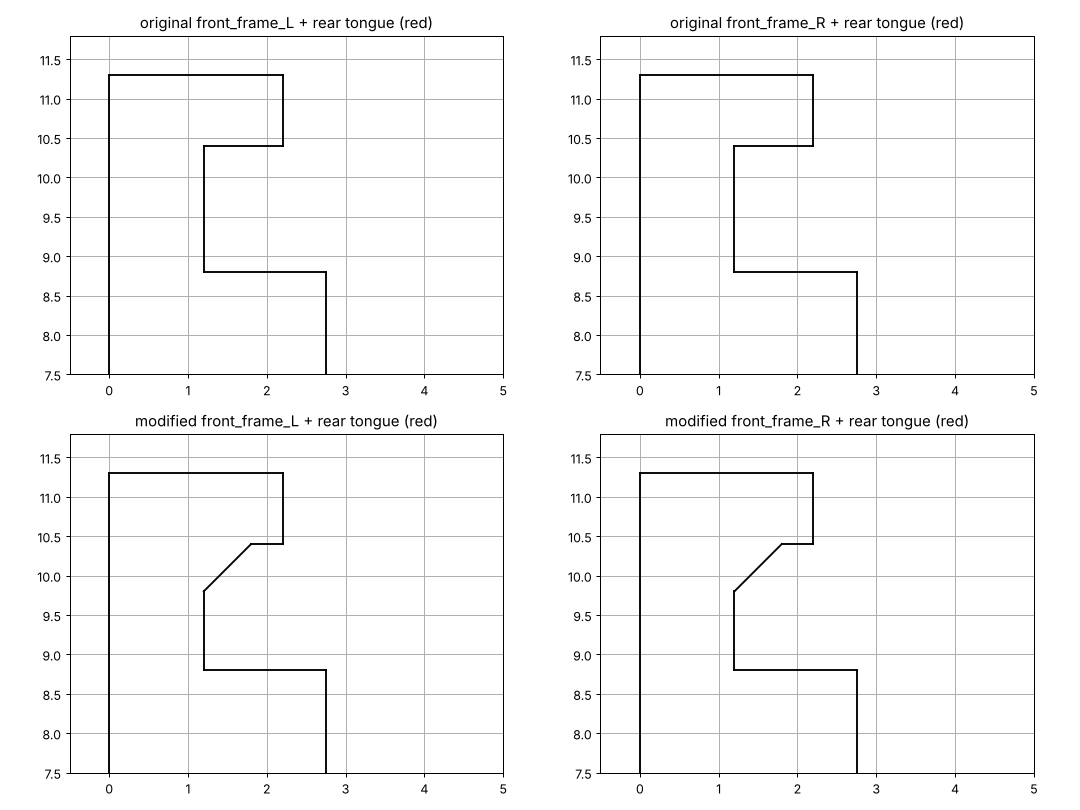
v3/3d_print_files/lip_fix_section.png
